luanabuscariolo/RoverMind-nanoGrump/tutorial/parte-2-o-que-e-llm.pdf

# Parte 2 — A Grande Ideia: o que é uma LLM

Onde estamos na jornada. Você já montou o corpo do robô (Parte 1). Antes de construir o cérebro dele (Parte 3), vamos entender — sem nenhum jargão — o que é uma "IA de linguagem", como ela funciona por dentro e por que uma versão minúscula dela pode morar num robozinho. Nenhum código aqui: só ideias.

"Inteligência Artificial" virou uma palavra assustadora. Parece coisa de gênio, de ficção científica, de algo que ninguém comum entende. A boa notícia desta parte é que, por baixo do capô, a ideia central é simples e elegante — e você vai entendê-la em poucos minutos.

## 2.1 O que significa "LLM"

LLM vem do inglês Large Language Model — em português, "Grande Modelo de Linguagem". Vamos quebrar o nome:

Modelo — um programa que aprende padrões a partir de exemplos, em vez de seguir regras que alguém escreveu à mão. (Pense num aprendiz que observa e imita, não num manual de instruções.)
Linguagem — o que ele aprende são padrões de texto: como as palavras e letras se seguem umas às outras.
Grande (Large) — normalmente esses modelos são enormes. O nosso vai ser pequeno de propósito, para caber num robô. Mas a ideia é a mesma.

Então uma LLM é, em resumo, um programa que aprendeu padrões de texto observando muitos exemplos. O ChatGPT é uma LLM gigante. O cérebro do nosso robô será uma LLM minúscula. Mesma família, tamanhos diferentes.

## 2.2 A única coisa que uma LLM faz

Aqui está o segredo que desmistifica tudo. Uma LLM, por mais impressionante que pareça, faz uma única coisa:

Ela prevê o próximo pedacinho de texto.

Você dá um começo, e ela adivinha o que vem a seguir:

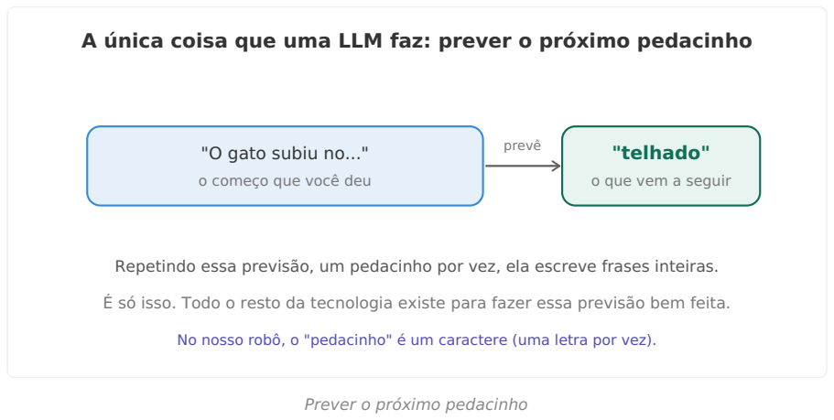
[picture p9: figure]
"O gato subiu no..."; o começo que você deu; prevê; "telhado"; o que vem a seguir; Prever o próximo pedacinho

A única coisa que uma LLM faz: prever o próximo pedacinho

Repetindo essa previsão, um pedacinho por vez, ela escreve frases inteiras.

É só isso. Todo o resto da tecnologia existe para fazer essa previsão bem feita.

No nosso robô, o "pedacinho" é um caractere (uma letra por vez).

Se você escreve "O gato subiu no...", a LLM prevê algo como "telhado". Como? Porque, observando muitos textos, ela aprendeu que depois de "subiu no" costumam vir palavras como "telhado", "muro", "sofá" — e raramente "banana".

E as frases inteiras? Simples: ela repete a previsão. Prevê uma palavra, junta ao texto, e prevê a próxima. E a próxima. Um pedacinho de cada vez, até formar frases, parágrafos, respostas inteiras. Toda a "mágica" das IAs de linguagem é essa previsão repetida milhares de vezes.

Uma comparação do dia a dia: é como o corretor do seu celular quando sugere a próxima palavra enquanto você digita. A LLM é uma versão muito mais poderosa da mesma ideia — prever o que vem a seguir.

## 2.3 Como ela "aprende" isso?

A LLM não nasce sabendo. Ela aprende num processo chamado treino, que funciona por tentativa e erro — parecido com um humano treinando um esporte.

Imagine mostrar a ela um texto com a última palavra tampada, e pedir que adivinhe. No começo, ela chuta aleatoriamente e erra quase sempre. Cada vez que erra, ela se ajusta um pouquinho para errar menos na próxima. Repetindo isso milhões de vezes com muitos textos, os chutes vão ficando cada vez melhores, até ela prever com naturalidade.

No fim do treino, o "conhecimento" da LLM fica guardado em um monte de números ajustados — chamados parâmetros. Cada parâmetro é como um botãozinho que o treino girou até a posição certa. Quanto mais botões, mais capaz (e mais pesado) o modelo.

Você vai fazer exatamente esse processo na Parte 3: mostrar exemplos ao modelo, ver o "erro" diminuir, e no fim ter um modelo que prevê texto no estilo do seu robô.

## 2.4 Por que uma LLM cabe num robô?

Aqui vem a pergunta natural: se o ChatGPT precisa de computadores gigantes, como um modelo desses cabe num chip de poucos dólares?

A resposta está no tamanho. Os modelos variam enormemente na quantidade de parâmetros (aqueles "botõezinhos"):

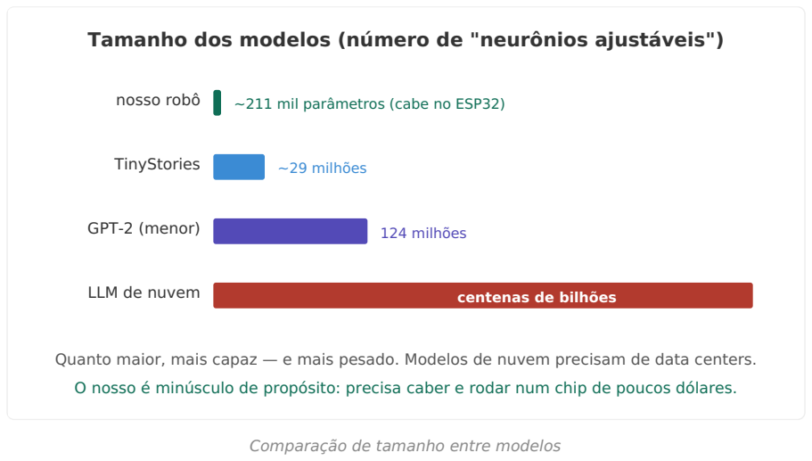
[picture p10: figure]
TinyStories; ~29 milhões; GPT-2 (menor); 124 milhões; LLM de nuvem; centenas de bilhões; Comparação de tamanho entre modelos

Tamanho dos modelos (número de "neurônios ajustáveis")

nosso robô ~211 mil parâmetros (cabe no ESP32)

Quanto maior, mais capaz — e mais pesado. Modelos de nuvem precisam de data centers. O nosso é minúsculo de propósito: precisa caber e rodar num chip de poucos dólares.

Um LLM de nuvem tem centenas de bilhões de parâmetros — por isso precisa de data centers. O nosso robô vai ter só ~211 mil. É milhões de vezes menor.

O truque: um modelo pequeno não sabe conversar sobre qualquer assunto. Mas ele não precisa. O nosso robô só precisa saber uma coisa: gerar frases sarcásticas curtas para umas poucas situações. Para essa tarefa limitada, um modelo minúsculo basta — e cabe folgado na memória de um microcontrolador.

A lição: você não precisa de um modelo gigante para um problema pequeno. Escolher o tamanho certo para a tarefa é uma decisão de engenharia inteligente, não uma limitação.

## 2.5 Como isso se conecta ao nosso robô

Juntando as peças do projeto:

O corpo (Parte 1) percebe o mundo: anda, detecta obstáculos, fica preso.
O cérebro (a LLM, Parte 3) recebe a situação atual e gera uma frase com personalidade.

A ponte entre os dois são os marcadores — etiquetas curtas que resumem a situação: <obstacle> (bateu em algo), <stuck> (ficou preso), <clear> (o caminho abriu). O corpo manda o marcador; o cérebro completa com uma reclamação sarcástica:

corpo: "<obstacle>"
cérebro: "<obstacle> Oh look, a wall. Groundbreaking. Turning."

Repare que isso é exatamente a previsão do próximo pedacinho que vimos na Seção 2.2 — só que o "começo" é um marcador de situação, e a LLM completa com a frase.

## 2.6 Alguns termos que você vai encontrar

Para você não se assustar com o vocabulário na Parte 3, aqui vão os principais, em linguagem simples (todos serão explicados a fundo com exemplos quando aparecerem):

Termo | O que significa, em uma frase
Token | Um pedacinho de texto. No nosso caso, um caractere.
Vocabulário | A lista de todos os pedacinhos que o modelo conhece.
Parâmetros | Os números ajustáveis que guardam o "conhecimento".
Treino | O processo de ajustar os parâmetros mostrando exemplos.
Embedding | Transformar um pedacinho de texto num conjunto de números.
Atenção | O mecanismo que faz cada pedacinho "olhar" para os outros.
Inferência | Usar o modelo já treinado para gerar texto (o contrário de treinar).

Não precisa decorar nada agora. Só saiba que, quando esses termos aparecerem, cada um virá com uma analogia, um exemplo com números pequenos e um diagrama.

## Encerramento da Parte 2

Agora você entende a grande ideia por trás das IAs de linguagem:

✅ Uma LLM é um programa que aprendeu padrões de texto observando exemplos ✅ A única coisa que ela faz é prever o próximo pedacinho — repetido, vira frases ✅ Ela aprende por tentativa e erro, ajustando parâmetros no treino
✅ Modelos pequenos servem para tarefas pequenas — por isso cabem num robô
✅ No nosso projeto, o corpo manda a situação e o cérebro completa com a frase

Você desmistificou a parte mais "assustadora" do projeto sem escrever uma linha de código. Na Parte 3, vamos transformar essa ideia em realidade — construindo, peça por peça, o cérebro do robô.
