luanabuscariolo/RoverMind-nanoGrump/firmware/firmware.ino

/*
  ============================================================
  firmware.ino  -  nano-grump no ESP32-S3
  ============================================================

  O que este firmware faz:
    1. Le os pesos do nano-grump da flash (particao "model")
    2. Aguarda um marcador chegar pela Serial
       ex: "<obstacle>\n"
    3. Gera uma frase sarcastica caractere por caractere
       (a mesma logica do generate.py, em C)
    4. Imprime a frase na Serial e no display OLED

  Organizacao:
    PARTE 1 - Configuracoes e estruturas de dados
    PARTE 2 - Funcoes matematicas (as contas dos demos)
    PARTE 3 - Forward pass (a inferencia completa)
    PARTE 4 - Geracao de texto (top-k + temperatura)
    PARTE 5 - setup() e loop()

  Parametros de geracao (mexa aqui para ajustar):
    TEMPERATURA  0.75  (igual ao generate.py)
    TOP_K        4     (igual ao generate.py)
    MAX_TOKENS   120   (limite de caracteres por frase)
  ============================================================
*/

#include <Arduino.h>
#include "esp_partition.h"    // acesso as particoes da flash
#include "esp_heap_caps.h"    // alocacao de memoria em PSRAM/SRAM
#include <math.h>             // expf(), sqrtf()
#include <string.h>           // memset(), strstr(), strncmp()

// ------------------------------------------------------------
// Display OLED SH1106 SPI (pinos confirmados no seu hardware)
// CLK=12, MOSI=11, CS=8, DC=9, RES=10
// ------------------------------------------------------------
#include <U8g2lib.h>
#include <SPI.h>

U8G2_SH1106_128X64_NONAME_F_4W_HW_SPI
  display(U8G2_R0, /*cs=*/8, /*dc=*/9, /*reset=*/10);

// ------------------------------------------------------------
// [NOVO] UART do CORPO (ESP32-WROOM-32)
// O corpo envia os marcadores pela sua UART2 (TX=GPIO17).
// Aqui no S3 recebemos por esta UART1, no RX=GPIO18.
// Ligacao fisica: WROOM GPIO17 -> S3 GPIO18, e GND <-> GND.
// So recebemos (RX); o TX fica num pino qualquer nao usado.
// ------------------------------------------------------------
#include <HardwareSerial.h>
HardwareSerial corpo(1);     // usa a UART1 do ESP32-S3
#define CORPO_RX_PIN 18      // recebe os marcadores do corpo aqui
#define CORPO_TX_PIN 17      // nao usado (so precisamos receber)


// ============================================================
// PARTE 1 — CONFIGURACOES E ESTRUTURAS DE DADOS
// ============================================================

// Parametros de geracao
#define TEMPERATURA   0.75f
#define TOP_K         4
#define MAX_TOKENS    120

// Hiperparametros do modelo (mesmos valores do model.py)
// Serao confirmados ao ler o cabecalho do .bin
#define VOCAB_SIZE  59
#define N_EMBD      64
#define BLOCK_SIZE  128     // [ALTERADO] 64 -> 128 (cabe frases longas ate 107 chars)
#define N_LAYER     4
#define N_HEADS     4
#define HEAD_SIZE   (N_EMBD / N_HEADS)   // 64 / 4 = 16
#define FFN_DIM     (4 * N_EMBD)         // 256

// Cabecalho do .bin (os mesmos 6 inteiros que o export.py escreveu)
struct __attribute__((packed)) Cabecalho {
  int vocab_size;
  int n_embd;
  int block_size;
  int n_layer;
  int n_heads;
  int reservado;
};

// Pesos de um unico bloco (atencao + FFN + layernorms)
// Cada campo e um ponteiro que aponta direto para a flash.
// Nao copiamos nada — lemos direto de onde o esptool gravou.
struct PesosBloco {
  const float *ln1_w, *ln1_b;          // layernorm 1 (peso e bias)
  const float *q_w, *k_w, *v_w;       // query, key, value
  const float *proj_w, *proj_b;        // projecao de saida da atencao
  const float *ln2_w, *ln2_b;          // layernorm 2
  const float *ffn1_w, *ffn1_b;        // FFN expandir (64->256)
  const float *ffn2_w, *ffn2_b;        // FFN contrair (256->64)
};

// Todos os pesos do modelo
struct Pesos {
  const float *emb_token;              // embedding de token  (59 x 64)
  const float *emb_pos;                // embedding de posicao (64 x 64)
  PesosBloco   blocos[N_LAYER];        // 4 blocos
  const float *ln_final_w, *ln_final_b; // layernorm final
  const float *saida_w;                // camada de saida (59 x 64)
};

// Vocabulario: os 59 caracteres (mesma ordem do vocab.json)
// Gerado a partir do vocab.json pelo script abaixo em Python:
//
//   import json
//   v = json.load(open("vocab.json"))["vocab"]
//   print("{" + ", ".join(f"'{c}'" if c not in ("'","\\") else
//         ("'\\''") if c=="'" else ("'\\\\'") for c in v) + "}")
//
// Cole o resultado na linha abaixo:
const char VOCAB[VOCAB_SIZE] = {
  '\n',' ','\'',',','-','.', ':','<','>','?',
  'A', 'B', 'C', 'D', 'E', 'F', 'G', 'H', 'I', 'J',
  'L', 'M', 'N', 'O', 'P', 'R', 'S', 'T', 'U', 'V',
  'W', 'Y', '_', 'a', 'b', 'c', 'd', 'e', 'f', 'g',
  'h', 'i', 'j', 'k', 'l', 'm', 'n', 'o', 'p', 'q',
  'r', 's', 't', 'u', 'v', 'w', 'x', 'y', 'z'
};

// Indice do caractere '\n' (fim de frase) — posicao 0 no vocab
#define TOKEN_NEWLINE 0

// Buffers de calculo na SRAM (pequenos, acessados muitas vezes)
// Declarados globalmente para nao estourar a pilha (stack)
static float x[N_EMBD];          // vetor atual do token
static float xb[N_EMBD];         // copia normalizada
static float q[N_EMBD];          // query
static float k_buf[N_EMBD];      // key
static float v_buf[N_EMBD];      // value
static float h[FFN_DIM];         // buffer intermediario da FFN
static float logits[VOCAB_SIZE]; // saida final (uma nota por caractere)

// Cache KV na PSRAM (cresce com a sequencia, ate BLOCK_SIZE posicoes)
// Guarda as keys e values de todas as posicoes anteriores —
// e o que permite a atencao "olhar para o passado".
static float *kv_cache_k = nullptr;  // (N_LAYER x BLOCK_SIZE x N_EMBD)
static float *kv_cache_v = nullptr;  // (N_LAYER x BLOCK_SIZE x N_EMBD)

// Pesos do modelo (ponteiros para a flash)
static Pesos w;


// ============================================================
// PARTE 2 — FUNCOES MATEMATICAS
// ============================================================
// Estas funcoes implementam as mesmas operacoes dos demos,
// em C. A matematica e identica — so o idioma mudou.

// ------------------------------------------------------------
// layernorm: normaliza um vetor EXATAMENTE como o nn.LayerNorm
// do model.py. Diferente do RMSNorm, o LayerNorm:
//   1. subtrai a MEDIA (centraliza em zero)
//   2. divide pelo desvio padrao
//   3. multiplica pelo peso (w) e SOMA o bias (b)
//
// [CORRIGIDO] antes era rmsnorm (sem media, sem bias). O modelo
// foi treinado com LayerNorm completo, entao o firmware precisa
// usar a mesma normalizacao — senao cada vetor sai distorcido e
// o erro se acumula, gerando palavras tortas.
// ------------------------------------------------------------
static void layernorm(float *out, const float *x,
                      const float *w, const float *b, int n) {
  // 1. media
  float media = 0.0f;
  for (int i = 0; i < n; i++) media += x[i];
  media /= n;

  // 2. variancia (media dos desvios ao quadrado)
  float var = 0.0f;
  for (int i = 0; i < n; i++) {
    float d = x[i] - media;
    var += d * d;
  }
  var /= n;

  // 3. normalizar, escalar (w) e deslocar (b)
  float inv_std = 1.0f / sqrtf(var + 1e-5f);
  for (int i = 0; i < n; i++)
    out[i] = w[i] * ((x[i] - media) * inv_std) + b[i];
}

// ------------------------------------------------------------
// matmul: multiplica matriz por vetor.
// out[i] = soma(A[i][j] * x[j]) para j de 0 a n-1
// e o que acontece dentro do Linear() do PyTorch.
// ------------------------------------------------------------
static void matmul(float *out, const float *x,
                   const float *A, int linhas, int colunas) {
  for (int i = 0; i < linhas; i++) {
    float acc = 0.0f;
    for (int j = 0; j < colunas; j++)
      acc += A[i * colunas + j] * x[j];
    out[i] = acc;
  }
}

// ------------------------------------------------------------
// softmax: converte notas em probabilidades que somam 1.
// (a mesma operacao do demo 3, etapa 4)
// ------------------------------------------------------------
static void softmax(float *x, int n) {
  float max_val = x[0];
  for (int i = 1; i < n; i++) if (x[i] > max_val) max_val = x[i];
  float soma = 0.0f;
  for (int i = 0; i < n; i++) { x[i] = expf(x[i] - max_val); soma += x[i]; }
  for (int i = 0; i < n; i++) x[i] /= soma;
}

// ------------------------------------------------------------
// relu: zera os negativos (a ativacao da FFN, demo 4)
// ------------------------------------------------------------
static void relu(float *x, int n) {
  for (int i = 0; i < n; i++) if (x[i] < 0.0f) x[i] = 0.0f;
}


// ============================================================
// PARTE 3 — FORWARD PASS (a inferencia completa)
// ============================================================
// Esta funcao e a traducao direta do model.py para C.
// Recebe um token e uma posicao, atualiza o cache KV,
// e preenche o array global "logits" com as notas finais.

static void forward(int token, int pos) {

  // 1. EMBEDDING (demo 1 + demo 2)
  // x = emb_token[token] + emb_posicao[pos]
  const float *te = w.emb_token + token * N_EMBD;
  const float *pe = w.emb_pos   + pos   * N_EMBD;
  for (int i = 0; i < N_EMBD; i++) x[i] = te[i] + pe[i];

  // 2. BLOCOS (demo 3 + demo 4 + demo 5, repetido N_LAYER vezes)
  for (int l = 0; l < N_LAYER; l++) {
    PesosBloco *b = &w.blocos[l];

    // --- SUB-CAMADA 1: ATENCAO MULTI-CABECA ---

    // 2a. LayerNorm antes da atencao (pre-norm, como no model.py)
    // [CORRIGIDO] agora usa layernorm completo (com bias ln1_b)
    layernorm(xb, x, b->ln1_w, b->ln1_b, N_EMBD);

    // 2b. Calcular Q, K, V (as tres "vistas" de cada token)
    matmul(q,     xb, b->q_w, N_EMBD, N_EMBD);
    matmul(k_buf, xb, b->k_w, N_EMBD, N_EMBD);
    matmul(v_buf, xb, b->v_w, N_EMBD, N_EMBD);

    // 2c. Guardar K e V no cache (para as posicoes futuras
    //     poderem "olhar para tras" — a mascara causal do demo 3)
    float *kc = kv_cache_k + l * BLOCK_SIZE * N_EMBD + pos * N_EMBD;
    float *vc = kv_cache_v + l * BLOCK_SIZE * N_EMBD + pos * N_EMBD;
    for (int i = 0; i < N_EMBD; i++) { kc[i] = k_buf[i]; vc[i] = v_buf[i]; }

    // 2d. ATENCAO MULTI-CABECA (demo 5)
    // Para cada cabeca, calculamos a atencao independentemente
    // numa fatia de HEAD_SIZE numeros (16 de 64).
    float att_out[N_EMBD] = {0};

    for (int h_idx = 0; h_idx < N_HEADS; h_idx++) {
      int offset = h_idx * HEAD_SIZE;  // inicio da fatia desta cabeca

      // Ponteiro para a fatia desta cabeca em Q
      float *q_h = q + offset;

      // Calcular notas: quanto esta posicao "presta atencao" a cada
      // posicao anterior (produto escalar Q . K, escalado)
      float scores[BLOCK_SIZE];
      for (int t = 0; t <= pos; t++) {
        float *k_h = kv_cache_k + l * BLOCK_SIZE * N_EMBD
                     + t * N_EMBD + offset;
        float dot = 0.0f;
        for (int i = 0; i < HEAD_SIZE; i++) dot += q_h[i] * k_h[i];
        scores[t] = dot / sqrtf((float)HEAD_SIZE);
      }

      // Softmax das notas (so ate "pos", mascara causal automatica)
      float max_s = scores[0];
      for (int t = 1; t <= pos; t++) if (scores[t] > max_s) max_s = scores[t];
      float soma = 0.0f;
      for (int t = 0; t <= pos; t++) { scores[t] = expf(scores[t]-max_s); soma += scores[t]; }
      for (int t = 0; t <= pos; t++) scores[t] /= soma;

      // Soma ponderada dos Values (pesos . V)
      for (int t = 0; t <= pos; t++) {
        float *v_h = kv_cache_v + l * BLOCK_SIZE * N_EMBD
                     + t * N_EMBD + offset;
        for (int i = 0; i < HEAD_SIZE; i++)
          att_out[offset + i] += scores[t] * v_h[i];
      }
    }

    // 2e. Projecao de saida da atencao + residual
    float proj_out[N_EMBD];
    matmul(proj_out, att_out, b->proj_w, N_EMBD, N_EMBD);
    for (int i = 0; i < N_EMBD; i++)
      x[i] += proj_out[i] + b->proj_b[i];

    // --- SUB-CAMADA 2: FFN (demo 4) ---

    // 2f. LayerNorm antes da FFN
    // [CORRIGIDO] agora usa layernorm completo (com bias ln2_b)
    layernorm(xb, x, b->ln2_w, b->ln2_b, N_EMBD);

    // 2g. Expandir: 64 -> 256
    matmul(h, xb, b->ffn1_w, FFN_DIM, N_EMBD);
    for (int i = 0; i < FFN_DIM; i++) h[i] += b->ffn1_b[i];
    relu(h, FFN_DIM);

    // 2h. Contrair: 256 -> 64  + residual
    float ffn_out[N_EMBD];
    matmul(ffn_out, h, b->ffn2_w, N_EMBD, FFN_DIM);
    for (int i = 0; i < N_EMBD; i++)
      x[i] += ffn_out[i] + b->ffn2_b[i];
  }

  // 3. LAYERNORM FINAL + CAMADA DE SAIDA
  // [CORRIGIDO] agora usa layernorm completo (com bias ln_final_b)
  layernorm(xb, x, w.ln_final_w, w.ln_final_b, N_EMBD);
  matmul(logits, xb, w.saida_w, VOCAB_SIZE, N_EMBD);
}



// ============================================================
// OLHOS DO NANO-GRUMP
// ============================================================
// A parte de IA/inferencia nao usa nada daqui.
// Os olhos sao apenas uma camada visual do OLED.
//
// Area reservada:
//   topo: 0..29   -> olhos
//   texto: 34..63 -> ate 3 linhas
//
// Cada marcador escolhe uma expressao diferente.
// ============================================================

// Estados dos olhos. Usamos int de propósito para evitar que o
// pré-processador do Arduino gere protótipos antes desta declaração.
#define OLHOS_NORMAL      0
#define OLHOS_FELIZ       1
#define OLHOS_CURIOSO     2
#define OLHOS_ALERTA      3
#define OLHOS_ESQUERDA    4
#define OLHOS_DIREITA     5
#define OLHOS_PREOCUPADO  6
#define OLHOS_TRAVADO     7
#define OLHOS_ALIVIADO    8

static int eye_state = OLHOS_NORMAL;

// Desenha um olho circular simples.
// cx/cy = centro; raio = tamanho.
static void olho_circular(int cx, int cy, int raio, int pupila_dx = 0) {
  display.drawCircle(cx, cy, raio);
  display.drawDisc(cx + pupila_dx, cy, 2);
}

// Desenha os dois olhos de acordo com o estado atual.
static void draw_eyes(int state) {
  const int L = 38;
  const int R = 90;
  const int CY = 14;

  // Expressao padrao: dois olhos redondos.
  if (state == OLHOS_NORMAL) {
    olho_circular(L, CY, 7, 0);
    olho_circular(R, CY, 7, 0);
    return;
  }

  // Feliz: olhos "sorrindo".
  if (state == OLHOS_FELIZ || state == OLHOS_ALIVIADO) {
    display.drawLine(L - 7, CY + 2, L, CY - 3);
    display.drawLine(L,     CY - 3, L + 7, CY + 2);
    display.drawLine(R - 7, CY + 2, R, CY - 3);
    display.drawLine(R,     CY - 3, R + 7, CY + 2);

    // Pequeno brilho/sorriso visual embaixo dos olhos.
    display.drawPixel(64, 27);
    return;
  }

  // Curioso: olhos grandes, pupilas deslocadas para cima.
  if (state == OLHOS_CURIOSO) {
    display.drawCircle(L, CY, 8);
    display.drawDisc(L + 2, CY - 2, 2);
    display.drawCircle(R, CY, 8);
    display.drawDisc(R + 2, CY - 2, 2);
    return;
  }

  // Alerta: olhos grandes e pupilas centradas.
  if (state == OLHOS_ALERTA) {
    display.drawCircle(L, CY, 9);
    display.drawDisc(L, CY, 3);
    display.drawCircle(R, CY, 9);
    display.drawDisc(R, CY, 3);
    return;
  }

  // Olhando para a esquerda.
  if (state == OLHOS_ESQUERDA) {
    olho_circular(L, CY, 7, -3);
    olho_circular(R, CY, 7, -3);
    return;
  }

  // Olhando para a direita.
  if (state == OLHOS_DIREITA) {
    olho_circular(L, CY, 7, 3);
    olho_circular(R, CY, 7, 3);
    return;
  }

  // Preocupado: sobrancelhas inclinadas para o centro.
  if (state == OLHOS_PREOCUPADO) {
    olho_circular(L, CY + 1, 7, 0);
    olho_circular(R, CY + 1, 7, 0);

    display.drawLine(L - 8, 4, L + 5, 1);
    display.drawLine(R - 5, 1, R + 8, 4);
    return;
  }

  // Travado/frustrado: olhos semicerrados.
  if (state == OLHOS_TRAVADO) {
    display.drawLine(L - 8, CY, L + 8, CY);
    display.drawLine(R - 8, CY, R + 8, CY);
    display.drawLine(L - 6, 5, L + 6, 5);
    display.drawLine(R - 6, 5, R + 6, 5);
    return;
  }
}

// Escolhe a expressao a partir do marcador recebido.
// Nao altera o texto nem a inferencia.
static int eye_state_from_prompt(const char *prompt) {
  if (strstr(prompt, "<start>"))       return OLHOS_FELIZ;
  if (strstr(prompt, "<explore>"))     return OLHOS_CURIOSO;
  if (strstr(prompt, "<obstacle>"))    return OLHOS_ALERTA;
  if (strstr(prompt, "<turn_left>"))   return OLHOS_ESQUERDA;
  if (strstr(prompt, "<turn_right>"))  return OLHOS_DIREITA;
  if (strstr(prompt, "<backup>"))      return OLHOS_PREOCUPADO;
  if (strstr(prompt, "<stuck>"))       return OLHOS_TRAVADO;
  if (strstr(prompt, "<clear>"))       return OLHOS_ALIVIADO;
  return OLHOS_NORMAL;
}

// ============================================================
// PARTE 4 — GERACAO DE TEXTO (top-k + temperatura)
// ============================================================
// Traducao direta do generate.py para C.

// Sorteia um indice proporcional as probabilidades em probs[].
// Usamos o gerador de numeros aleatorios do Arduino (random()).
static int amostrar(float *probs, int n) {
  float r = (float)random(10000) / 10000.0f;
  float acum = 0.0f;
  for (int i = 0; i < n; i++) {
    acum += probs[i];
    if (r < acum) return i;
  }
  return n - 1;
}

// Gera uma frase a partir de um prompt (string com o marcador).
// Imprime cada caractere na Serial e no display conforme gera.
static void gerar(const char *prompt) {

  // Zerar o cache KV (comecar uma nova sequencia do zero)
  memset(kv_cache_k, 0,
         N_LAYER * BLOCK_SIZE * N_EMBD * sizeof(float));
  memset(kv_cache_v, 0,
         N_LAYER * BLOCK_SIZE * N_EMBD * sizeof(float));

  // Converter o prompt em tokens (encode — igual ao tokenizer.py)
  int tokens[BLOCK_SIZE];
  int n_prompt = 0;
  for (int c = 0; prompt[c] != '\0' && n_prompt < BLOCK_SIZE; c++) {
    for (int v = 0; v < VOCAB_SIZE; v++) {
      if (VOCAB[v] == prompt[c]) { tokens[n_prompt++] = v; break; }
    }
  }

  // Alimentar o prompt no modelo (sem gerar saida ainda)
  int pos = 0;
  for (int i = 0; i < n_prompt; i++) {
    forward(tokens[i], pos++);
  }

  // Gerar caracteres um por um (autorregressivo)
  // [ADICIONADO] buffer que acumula a frase inteira gerada,
  // para renderizar no display de uma vez (com quebra por palavra).
  // Comeca com o proprio prompt (o marcador), para ele aparecer junto.
  char frase_buf[192];
  int  frase_len = 0;
  for (int i = 0; prompt[i] != '\0' && frase_len < (int)sizeof(frase_buf)-1; i++)
    frase_buf[frase_len++] = prompt[i];
  frase_buf[frase_len] = '\0';

  Serial.print(prompt);
  for (int step = 0; step < MAX_TOKENS && pos < BLOCK_SIZE; step++) {

    // Aplicar temperatura: dividir os logits pela temperatura
    // (igual ao generate.py: logits / temperatura)
    for (int v = 0; v < VOCAB_SIZE; v++)
      logits[v] /= TEMPERATURA;

    // TOP-K: manter so os K maiores logits,
    // colocar -infinito nos demais
    float top_vals[TOP_K];
    for (int i = 0; i < TOP_K; i++) top_vals[i] = -1e30f;
    for (int v = 0; v < VOCAB_SIZE; v++) {
      if (logits[v] > top_vals[TOP_K-1]) {
        top_vals[TOP_K-1] = logits[v];
        // ordenar (bubble sort simples — TOP_K e pequeno)
        for (int i = TOP_K-1; i > 0 && top_vals[i] > top_vals[i-1]; i--) {
          float tmp = top_vals[i]; top_vals[i] = top_vals[i-1]; top_vals[i-1] = tmp;
        }
      }
    }
    float corte = top_vals[TOP_K-1];
    for (int v = 0; v < VOCAB_SIZE; v++)
      if (logits[v] < corte) logits[v] = -1e30f;

    // Softmax -> probabilidades
    softmax(logits, VOCAB_SIZE);

    // Sortear o proximo token
    int next_token = amostrar(logits, VOCAB_SIZE);

    // Se gerou '\n', a frase acabou
    if (next_token == TOKEN_NEWLINE) break;

    // Imprimir o caractere gerado na Serial
    char c = VOCAB[next_token];
    Serial.print(c);

    // [ALTERADO] em vez de mandar char a char pro display (o que
    // causava quebra no meio da palavra), acumulamos a frase inteira
    // num buffer e renderizamos de uma vez no fim, com quebra por
    // palavra e scroll. Ver display_render() abaixo.
    if (frase_len < (int)sizeof(frase_buf) - 1) {
      frase_buf[frase_len++] = c;
      frase_buf[frase_len]   = '\0';
    }

    // Avancar o modelo com o token gerado
    forward(next_token, pos++);
  }

  Serial.println();
  display_render(frase_buf);   // renderiza a frase completa com scroll
}


// ============================================================
// PARTE 5 — SETUP E LOOP
// ============================================================

void setup() {
  Serial.begin(115200);
  delay(1500);
  Serial.println("\n=== nano-grump v2 ===");

  // [NOVO] Inicializa a UART que recebe os marcadores do corpo.
  // 9600 baud (mesma velocidade do corpo), 8N1.
  corpo.begin(9600, SERIAL_8N1, CORPO_RX_PIN, CORPO_TX_PIN);
  Serial.println("UART do corpo iniciada (RX=GPIO18, 9600 baud).");

  // --- 1. Encontrar e mapear a particao "model" ---
  const esp_partition_t *part = esp_partition_find_first(
    ESP_PARTITION_TYPE_DATA, (esp_partition_subtype_t)0x40, "model");
  if (!part) {
    Serial.println("ERRO: particao 'model' nao encontrada."); return;
  }
  const void *base;
  esp_partition_mmap_handle_t handle;
  if (esp_partition_mmap(part, 0, part->size,
      ESP_PARTITION_MMAP_DATA, &base, &handle) != ESP_OK) {
    Serial.println("ERRO: mmap falhou."); return;
  }
  Serial.println("Particao mapeada.");

  // --- 2. Verificar o cabecalho ---
  const Cabecalho *cab = (const Cabecalho *)base;
  if (cab->vocab_size != VOCAB_SIZE || cab->n_embd != N_EMBD ||
      cab->block_size != BLOCK_SIZE || cab->n_layer != N_LAYER ||
      cab->n_heads    != N_HEADS) {
    Serial.println("ERRO: cabecalho nao bate com o firmware."); return;
  }
  Serial.println("Cabecalho OK.");

  // --- 3. Apontar os pesos para a flash (sem copiar nada) ---
  // Comecamos logo apos o cabecalho (24 bytes)
  const float *p = (const float *)((const uint8_t *)base + 24);

  w.emb_token = p; p += VOCAB_SIZE * N_EMBD;   // 59 x 64
  w.emb_pos   = p; p += BLOCK_SIZE * N_EMBD;   // 64 x 64

  for (int l = 0; l < N_LAYER; l++) {
    PesosBloco *b = &w.blocos[l];
    b->ln1_w  = p; p += N_EMBD;
    b->ln1_b  = p; p += N_EMBD;
    b->q_w    = p; p += N_EMBD * N_EMBD;
    b->k_w    = p; p += N_EMBD * N_EMBD;
    b->v_w    = p; p += N_EMBD * N_EMBD;
    b->proj_w = p; p += N_EMBD * N_EMBD;
    b->proj_b = p; p += N_EMBD;
    b->ln2_w  = p; p += N_EMBD;
    b->ln2_b  = p; p += N_EMBD;
    b->ffn1_w = p; p += FFN_DIM * N_EMBD;
    b->ffn1_b = p; p += FFN_DIM;
    b->ffn2_w = p; p += N_EMBD * FFN_DIM;
    b->ffn2_b = p; p += N_EMBD;
  }

  w.ln_final_w = p; p += N_EMBD;
  w.ln_final_b = p; p += N_EMBD;
  w.saida_w    = p;

  Serial.println("Pesos mapeados.");

  // --- 4. Alocar cache KV na PSRAM ---
  size_t kv_bytes = N_LAYER * BLOCK_SIZE * N_EMBD * sizeof(float);
  kv_cache_k = (float *)heap_caps_malloc(kv_bytes, MALLOC_CAP_SPIRAM);
  kv_cache_v = (float *)heap_caps_malloc(kv_bytes, MALLOC_CAP_SPIRAM);
  if (!kv_cache_k || !kv_cache_v) {
    Serial.println("ERRO: falha ao alocar cache KV na PSRAM."); return;
  }
  Serial.printf("Cache KV alocado: %.1f KB na PSRAM\n",
                2 * kv_bytes / 1024.0f);

  // --- 5. Inicializar o display OLED ---
  display.begin();
  display.clearBuffer();
  display.setFont(u8g2_font_6x10_tf);
  draw_eyes(OLHOS_NORMAL);
  display.drawHLine(0, 31, 128);
  display.drawStr(0, 42, "nano-grump v2");
  display.drawStr(0, 52, "aguardando...");
  display.sendBuffer();

  Serial.println("Display OK.");
  Serial.println("\nPronto. Envie um marcador pela Serial:");
  Serial.println("  <start>, <explore>, <obstacle>,");
  Serial.println("  <turn_left>, <turn_right>,");
  Serial.println("  <backup>, <stuck>, <clear>");
}

// Buffer para acumular o marcador recebido pela Serial
static char input_buf[32];
static int  input_len = 0;

// ------------------------------------------------------------
// [REESCRITO] display_render — renderiza a frase inteira no OLED
// com QUEBRA POR PALAVRA e SCROLL.
//
// Antes: display_char/display_flush escreviam char a char em 3
// linhas fixas, quebrando no meio das palavras e perdendo texto
// quando passava de 3 linhas.
//
// Agora: recebe a frase completa, quebra em linhas SEM cortar
// palavras, e se passar de 5 linhas, rola (mostra as ultimas 5).
//
// Medidas do display 128x64 com a fonte 6x10:
//   largura : 128 / 6 = 21 caracteres por linha
//   altura  : 64 / 12  = 5 linhas visiveis
// ------------------------------------------------------------

#define DISPLAY_COLS   21    // largura aproximada em caracteres com a fonte 6x10
#define DISPLAY_ROWS   3     // 3 linhas abaixo dos olhos
#define MAX_LINHAS     32    // buffer visual para frases longas

// Velocidade da "fala".
// Menor = mais rapido; maior = mais lento.
#define SPEAK_DELAY_MS 450

// Estado visual da fala.
static char speak_lines[MAX_LINHAS][DISPLAY_COLS + 1];
static int speak_line_count = 0;
static int speak_current_line = 0;

// Limpa o buffer de texto da fala.
static void speak_clear() {
  for (int i = 0; i < MAX_LINHAS; i++)
    speak_lines[i][0] = '\0';

  speak_line_count = 1;
  speak_current_line = 0;
}

// Adiciona uma palavra ao buffer, quebrando por palavras.
// O buffer pode ter muitas linhas; o display mostra somente as ultimas 3.
static void speak_add_word(const char *word) {
  if (word == nullptr || word[0] == '\0')
    return;

  int len = strlen(word);

  // Palavra maior que a largura: quebra em pedacos.
  while (len > DISPLAY_COLS) {
    if (speak_current_line >= MAX_LINHAS)
      return;

    int available = DISPLAY_COLS - (int)strlen(speak_lines[speak_current_line]);

    // Se a linha atual ja tem texto, termina-a antes de quebrar a palavra.
    if (available > 0 && strlen(speak_lines[speak_current_line]) > 0) {
      speak_current_line++;
      if (speak_current_line >= MAX_LINHAS)
        return;
      if (speak_current_line + 1 > speak_line_count) speak_line_count = speak_current_line + 1;
    }

    strncpy(speak_lines[speak_current_line], word, DISPLAY_COLS);
    speak_lines[speak_current_line][DISPLAY_COLS] = '\0';

    word += DISPLAY_COLS;
    len -= DISPLAY_COLS;

    speak_current_line++;
    if (speak_current_line >= MAX_LINHAS)
      return;

    if (speak_current_line + 1 > speak_line_count) speak_line_count = speak_current_line + 1;
  }

  if (len <= 0)
    return;

  int current_len = strlen(speak_lines[speak_current_line]);

  // Se a palavra nao couber, cria uma nova linha.
  if (current_len > 0 && current_len + 1 + len > DISPLAY_COLS) {
    speak_current_line++;

    if (speak_current_line >= MAX_LINHAS)
      return;

    speak_lines[speak_current_line][0] = '\0';
    if (speak_current_line + 1 > speak_line_count) speak_line_count = speak_current_line + 1;
    current_len = 0;
  }

  if (current_len > 0) {
    speak_lines[speak_current_line][current_len++] = ' ';
    speak_lines[speak_current_line][current_len] = '\0';
  }

  strncat(speak_lines[speak_current_line], word,
          DISPLAY_COLS - strlen(speak_lines[speak_current_line]));
}

// Desenha os olhos e as ultimas 3 linhas acumuladas.
// O scroll vertical usa um pequeno deslocamento em pixels para evitar
// a troca brusca de uma tela inteira para outra.
static void speak_draw(int scroll_y = 0) {
  display.clearBuffer();
  display.setFont(u8g2_font_6x10_tf);

  draw_eyes(eye_state);

  // Separador entre olhos e texto.
  display.drawHLine(0, 31, 128);

  int first = speak_line_count - DISPLAY_ROWS;
  if (first < 0)
    first = 0;

  int y = 42 - scroll_y;

  for (int i = first; i < speak_line_count; i++) {
    display.drawStr(0, y, speak_lines[i]);
    y += 10;
  }

  display.sendBuffer();
}

// Faz uma transicao suave quando uma nova linha entra.
// A linha nova sobe enquanto as anteriores acompanham o movimento.
static void speak_smooth_scroll() {
  // A linha nova normalmente entra quando passamos da 3a linha.
  // 10 pixels = altura aproximada da fonte 6x10.
  for (int offset = 1; offset <= 10; offset++) {
    speak_draw(offset);
    delay(18);
  }

  speak_draw(0);
}

// Pausa natural depois da palavra, considerando a pontuacao.
// A pausa base de 450 ms continua valendo para toda palavra.
static void speak_natural_pause(const char *word) {
  int len = strlen(word);

  if (len <= 0) {
    delay(SPEAK_DELAY_MS);
    return;
  }

  char last = word[len - 1];

  // Pausas adicionais para dar ritmo de fala.
  if (last == ',') {
    delay(SPEAK_DELAY_MS + 250);
  } else if (last == ';' || last == ':') {
    delay(SPEAK_DELAY_MS + 300);
  } else if (last == '.' || last == '!' || last == '?') {
    delay(SPEAK_DELAY_MS + 650);
  } else {
    delay(SPEAK_DELAY_MS);
  }
}

// Mostra uma frase progressivamente, palavra por palavra.
// Quando as 3 linhas ficam cheias, o texto sobe suavemente.
void display_speak(const char *frase) {
  speak_clear();
  speak_draw(0);

  const char *p = frase;

  while (*p != '\0') {
    // Pula espacos.
    while (*p == ' ')
      p++;

    if (*p == '\0')
      break;

    char word[64];
    int n = 0;

    while (*p != '\0' && *p != ' ' && n < (int)sizeof(word) - 1) {
      word[n++] = *p++;
    }

    word[n] = '\0';

    // Guardamos quantas linhas existiam antes.
    int old_line_count = speak_line_count;

    speak_add_word(word);

    // Se nasceu uma nova linha e ja precisamos rolar a tela,
    // faz a transicao pixel a pixel.
    bool needs_scroll =
      (speak_line_count > DISPLAY_ROWS &&
       speak_line_count > old_line_count &&
       (speak_line_count - DISPLAY_ROWS) > (old_line_count - DISPLAY_ROWS));

    if (needs_scroll) {
      speak_smooth_scroll();
    } else {
      speak_draw(0);
    }

    speak_natural_pause(word);
  }
}

// Mantemos display_render() como compatibilidade com o restante do firmware.
// Agora ele usa o modo de fala progressiva.
void display_render(const char *frase) {
  display_speak(frase);
}

// [NOVO] Processa um marcador recebido (de qualquer fonte).
// Extraido para funcao propria para ser reusado pela Serial USB
// e pela UART do corpo, sem duplicar codigo.
static void processarMarcador(const char *marcador) {
  // Verificar se e um marcador valido
  if (strncmp(marcador, "<", 1) == 0) {
    // Escolher a expressao dos olhos antes de gerar a frase.
    eye_state = eye_state_from_prompt(marcador);

    // Adicionar espaco apos o marcador (como o generate.py faz)
    char prompt[34];
    snprintf(prompt, sizeof(prompt), "%s ", marcador);
    Serial.printf("\nGerando para: %s\n", marcador);
    gerar(prompt);
  } else {
    Serial.println("Marcador invalido. Use: <start>, <obstacle>, etc.");
  }
}

// [NOVO] Buffer separado para a UART do corpo (independente do USB).
static char corpo_buf[32];
static int  corpo_len = 0;

void loop() {
  // ----------------------------------------------------------
  // FONTE 1: Serial USB (voce digitando marcadores para testar)
  // ----------------------------------------------------------
  while (Serial.available()) {
    char c = Serial.read();
    if (c == '\n' || c == '\r') {
      if (input_len > 0) {
        input_buf[input_len] = '\0';
        processarMarcador(input_buf);
        input_len = 0;
      }
    } else if (input_len < 31) {
      input_buf[input_len++] = c;
    }
  }

  // ----------------------------------------------------------
  // [NOVO] FONTE 2: UART do corpo (WROOM-32 enviando marcadores)
  // Mesma logica da Serial USB, mas lendo da porta "corpo".
  // ----------------------------------------------------------
  while (corpo.available()) {
    char c = corpo.read();
    if (c == '\n' || c == '\r') {
      if (corpo_len > 0) {
        corpo_buf[corpo_len] = '\0';
        Serial.printf("[CORPO] recebido: %s\n", corpo_buf);
        processarMarcador(corpo_buf);
        corpo_len = 0;
      }
    } else if (corpo_len < 31) {
      corpo_buf[corpo_len++] = c;
    }
  }
}
