luanabuscariolo/RoverMind-nanoGrump/(commit log)

2026-08-11 update dataset - frases alteradas para melhores pesos
2026-08-11 feat: criação do novo dataset
    de 40 frases por marcador para 300. Total:2400 novas frases
2026-08-11 v2: multi-head attention + dataset expandido + top-k
    - model.py: atenção multi-cabeça (4 heads), n_embd/block 64, 4 layers, vocab automático
    - dataset_gen.py: gerador por moldes (2400 frases sintéticas)
    - robot_voice_final.txt: 2491 frases (91 originais + 2400 geradas)
    - tokenizer.py: vocab.json v2 com metadados + validação
    - train.py: train/val split, checkpoint do melhor modelo, weight_decay
    - generate.py: top-k + temperatura configurável (top_k=4, temp=0.75)
    - 05_multihead_demo.py: demo didático de atenção multi-cabeça
    - MODEL_CARD.md: ficha técnica v2
    - best val loss: 1.3971 (211k params)
2026-08-12 refactor: mover demos para pasta demos/
2026-08-12 refactor: mover demos/ e tutorial para rastreamento
2026-08-12 feat: Traduzir o modelo_treinado.pt para um arquivo nano-grump.bin
2026-08-13 feat: Abre a partição "model", lê o cabeçalho e imprime os 6 valores na Serial
    [partitions.csv]
2026-08-14 atualizar de rmsnorm para layernorm e tamanho de block size de 64 para 128
2026-08-14 feat: conecta os esp32 body e brain
2026-08-14 feat: adiciona código ao ESP32 que controla os sensores e toda a lógica exploratória
