luanabuscariolo/RoverMind-nanoGrump/(notices)

Notices in the files:
README.md:
Docs: CC BY-NC-SA 4.0
